georgeuy2/cs179j/README.md

# cs179j
My senior project is for home decoration. It is a matrix of magnets that uses ferrofluid to display shapes or text.
