georgeuy2/cs179j/bearingmout_v5.stl

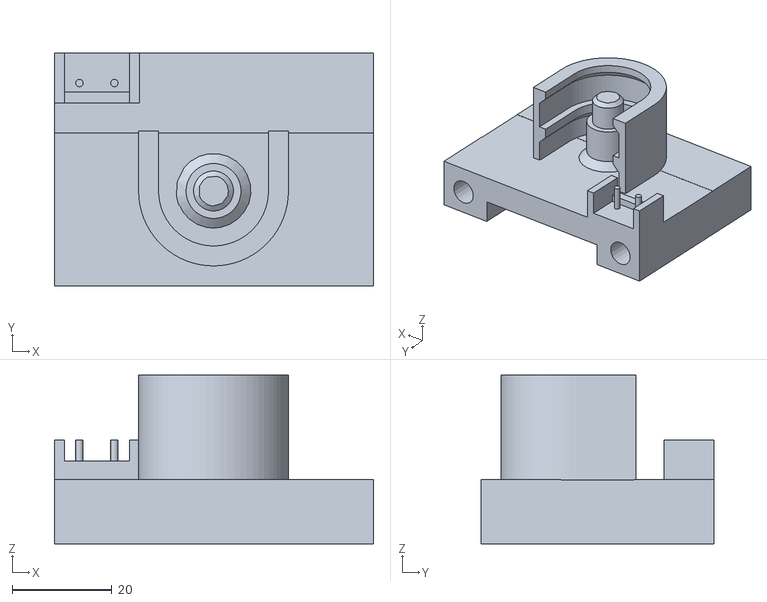
[picture p1: CAD file, 2017-05-19]
bearingmout_v5.stl
63.9 x 46.6 x 33.8
