georgeuy2/cs179j/magnet_slider_v3.stl

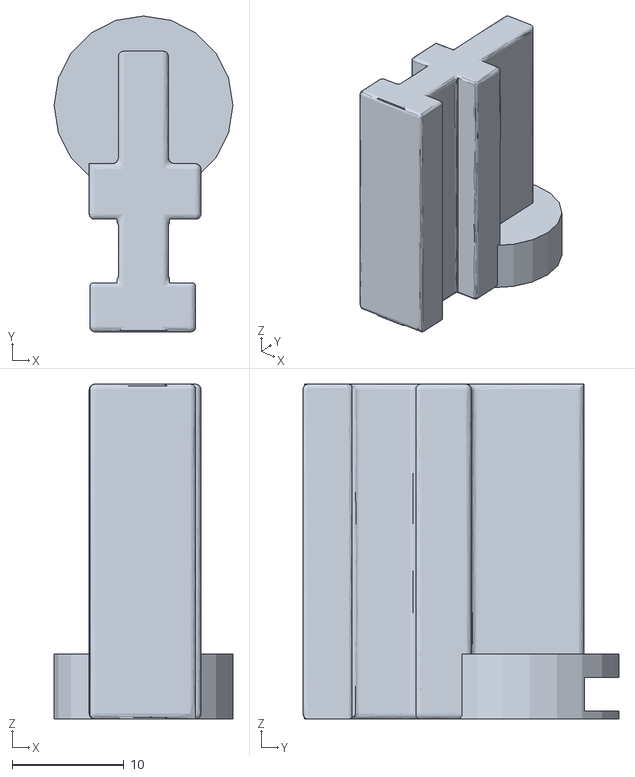
[picture p2: CAD file, 2017-05-19]
magnet_slider_v3.stl
16.0 x 28.3 x 30.0
