georgeuy2/cs179j/motormount_v3.stl

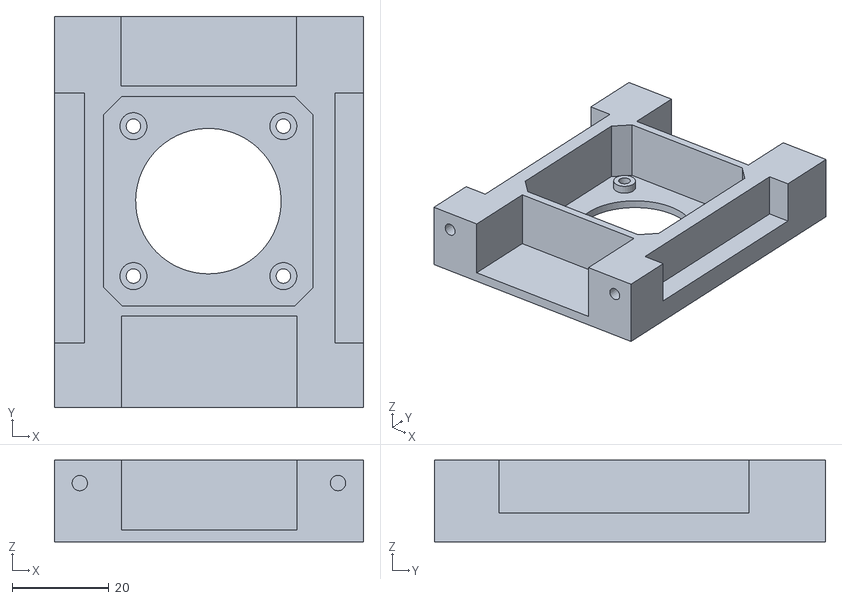
[picture p3: CAD file, 2017-05-19]
motormount_v3.stl
63.9 x 80.9 x 16.9
