georgeuy2/cs179j/5mm_25mm_pulley_v1.stl

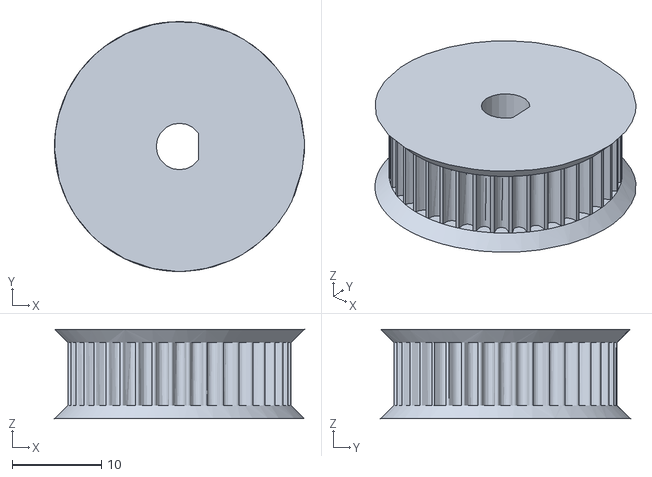
[picture p4: CAD file, 2017-05-19]
5mm_25mm_pulley_v1.stl
28.0 x 28.0 x 10.00
