georgeuy2/cs179j/carriege_v5.stl

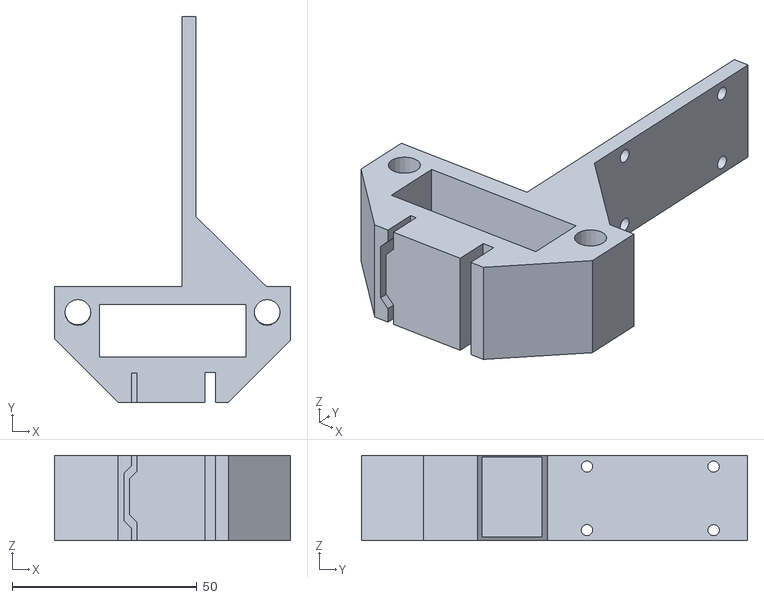
[picture p5: CAD file, 2017-05-19]
carriege_v5.stl
63.9 x 104.4 x 23.0
