georgeuy2/cs179j/Slider_Beam.stl

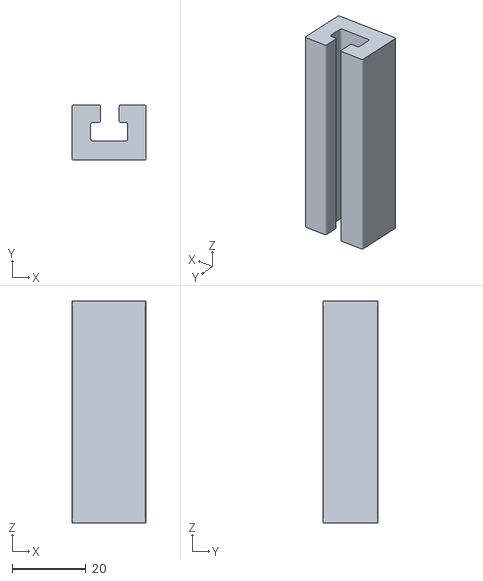
[picture p6: CAD file, 2017-05-19]
Slider_Beam.stl
20.0 x 15.0 x 60.0
