georgeuy2/cs179j/(commit log)

2017-05-19 added stl files for 3D printed parts
    [5mm_25mm_pulley_v1.stl, Slider_Beam.stl, bearingmout_v5.stl, carriege_v5.stl, magnet_slider_v3.stl, motormount_v3.stl]
2017-06-08 MAJOR CHANGE! States working.
    Currently, touchsreen can tell what cells to go to. I did not implement the solenoids because I had to get working ones. Currently only 2 motors work because the three motor drivers burned.
    [Main.ino, Solenoid.cpp, Solenoid.h, Stepper.ino, StepperMotor.cpp, StepperMotor.h, TouchScreenDisplay.ino]
